pdxbadgers/pcb-2015/gear.bmp

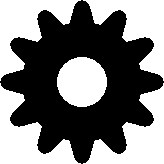
gear.bmp
