pdxbadgers/pcb-2015/badger.brd

## EAGLE design badger.brd (2015-10-04)

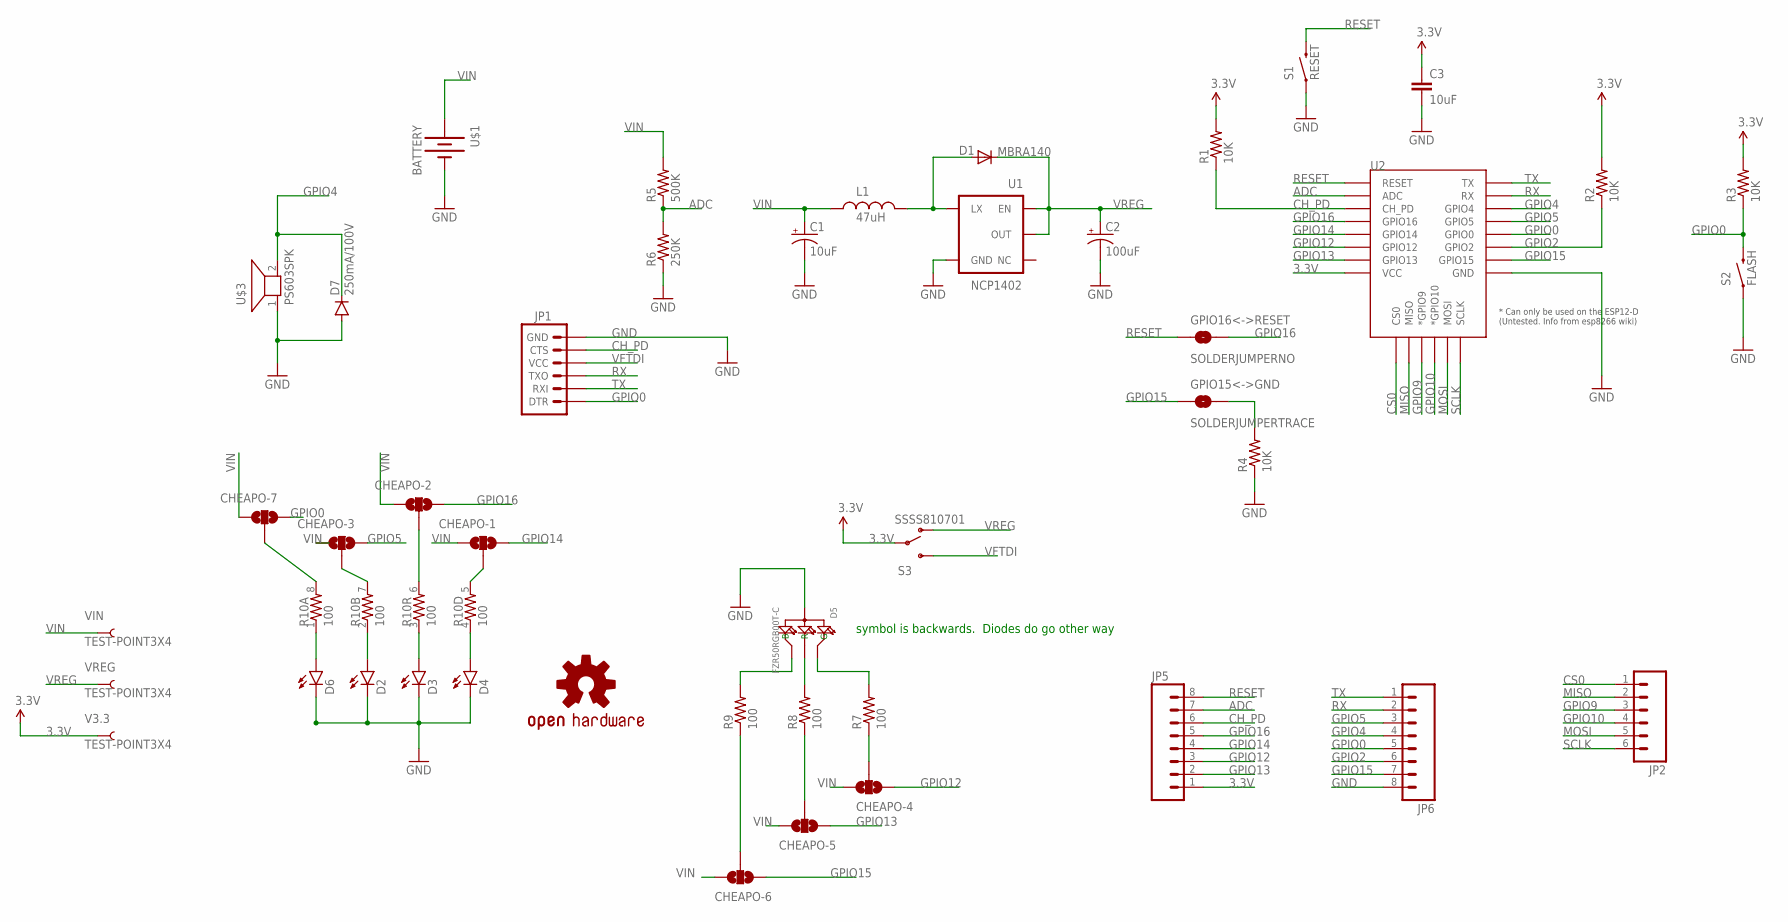
[picture p2: schematic badger.sch]

Parts:
C1: 10uF; EIA3216
C2: 100uF; EIA3528
C3: 10uF; 0603-CAP
CHEAPO-1, CHEAPO-2, CHEAPO-3, CHEAPO-4, CHEAPO-5, CHEAPO-6, CHEAPO-7: SOLDERJUMPER_2WAYT; SJ_2
D1: MBRA140; SMA-DIODE
D2, D3, D4, D6: LED-3MM-NO_SILK; LED3MM-NS
D5: FZR50RGB00T-C; LED4-1.3-D5.0MM
D7: 250mA/100V; SOD-323
GPIO15<->GND: SOLDERJUMPERTRACE; SJ_2S-TRACE
GPIO16<->RESET: SOLDERJUMPERNO; SJ_2S-NO
JP1: ARDUINO_SERIAL_PROGRAMLOCK; 1X06_LOCK
JP2: M06LOCK; 1X06_LOCK
JP5, JP6: M08LOCK; 1X08_LOCK
L1: 47uH; CR54
LOGO1: OSHW-LOGOL-COPPER; OSHW-LOGO-L_COPPER
R1, R2, R3, R4: 10K; 0603-RES
R5: 500K; 0603-RES
R6: 250K; 0603-RES
R7, R8, R9: 100; 1206
R10: 100; 0603-ARV
S1: RESET; TACTILE-SWITCH-SMD
S2: FLASH; TACTILE-SWITCH-SMD
S3: SSSS810701; SSSS8
U1: NCP1402; SOT23-5
U2: ESP12ESMD; ESP12E-SMD
U$1: BATTERY; HOLDER
U$3: PS603SPK; PS603
V3.3: TEST-POINT3X4; PAD.03X.04
VIN: TEST-POINT3X4; PAD.03X.04
VREG: TEST-POINT3X4; PAD.03X.04

Connections:
3.3V: C3.1, JP5.1, R1.2, R2.2, R3.2, S3.P$2, U2.VCC, V3.3.P$1
ADC: JP5.7, R5.1, R6.2, U2.ADC
CH_PD: JP1.5 (CTS), JP5.6, R1.1, U2.CH_PD
CS0: JP2.1, U2.CS0
GND: C1.C (-), C2.C (-), C3.2, D2.K (C), D3.K (C), D4.K (C), D5.C (+), D6.K (C), D7.A, JP1.6 (GND), JP6.8, R4.1, R6.1, S1.1, S2.1, U1.4 (GND), U2.GND, U$1.P$2 (-), U$3.1
GPIO0: CHEAPO-7.3, JP1.1 (DTR), JP6.5, R3.1, S2.3 (2), U2.GPIO0
GPIO2: JP6.6, R2.1, U2.GPIO2
GPIO4: D7.C, JP6.4, U2.GPIO4, U$3.2
GPIO5: CHEAPO-3.3, JP6.3, U2.GPIO5
GPIO9: JP2.3, U2.GPIO9 (*GPIO9)
GPIO10: JP2.4, U2.GPIO10 (*GPIO10)
GPIO12: CHEAPO-4.1, JP5.3, U2.GPIO12
GPIO13: CHEAPO-5.1, JP5.2, U2.GPIO13
GPIO14: CHEAPO-1.3, JP5.4, U2.GPIO14
GPIO15: CHEAPO-6.1, GPIO15<->GND.1, JP6.7, U2.GPIO15
GPIO16: CHEAPO-2.3, GPIO16<->RESET.2, JP5.5, U2.GPIO16
MISO: JP2.2, U2.MISO
MOSI: JP2.5, U2.MOSI
unnamed: GPIO15<->GND.2, R4.2
unnamed: D5.R, R8.2
unnamed: D1.A, L1.P$2 (2), U1.5 (LX)
unnamed: D5.G, R7.2
unnamed: D2.A, R10.2 (1)
unnamed: D3.A, R10.3 (1)
unnamed: D4.A, R10.4 (1)
unnamed: D5.B, R9.2
unnamed: CHEAPO-4.2, R7.1
unnamed: D6.A, R10.1
unnamed: CHEAPO-5.2, R8.1
unnamed: CHEAPO-3.2, R10.7 (2)
unnamed: CHEAPO-2.2, R10.6 (2)
unnamed: CHEAPO-1.2, R10.5 (2)
unnamed: CHEAPO-7.2, R10.8 (2)
unnamed: CHEAPO-6.2, R9.1
RESET: GPIO16<->RESET.1, JP5.8, S1.3 (2), U2.RESET
RX: JP1.3 (TXO), JP6.2, U2.RXD0 (RX)
SCLK: JP2.6, U2.SCLK
TX: JP1.2 (RXI), JP6.1, U2.TXD0 (TX)
VFTDI: JP1.4 (VCC), S3.P$1 (S)
VIN: C1.A (+), CHEAPO-1.1, CHEAPO-2.1, CHEAPO-3.1, CHEAPO-4.3, CHEAPO-5.3, CHEAPO-6.3, CHEAPO-7.1, L1.P$1 (1), R5.2, U$1.P$1 (+), VIN.P$1
VREG: C2.A (+), D1.C, S3.P$3 (O), U1.1 (EN), U1.2 (OUT), VREG.P$1

Notes on the sheet:
symbol is backwards. Diodes do go other way

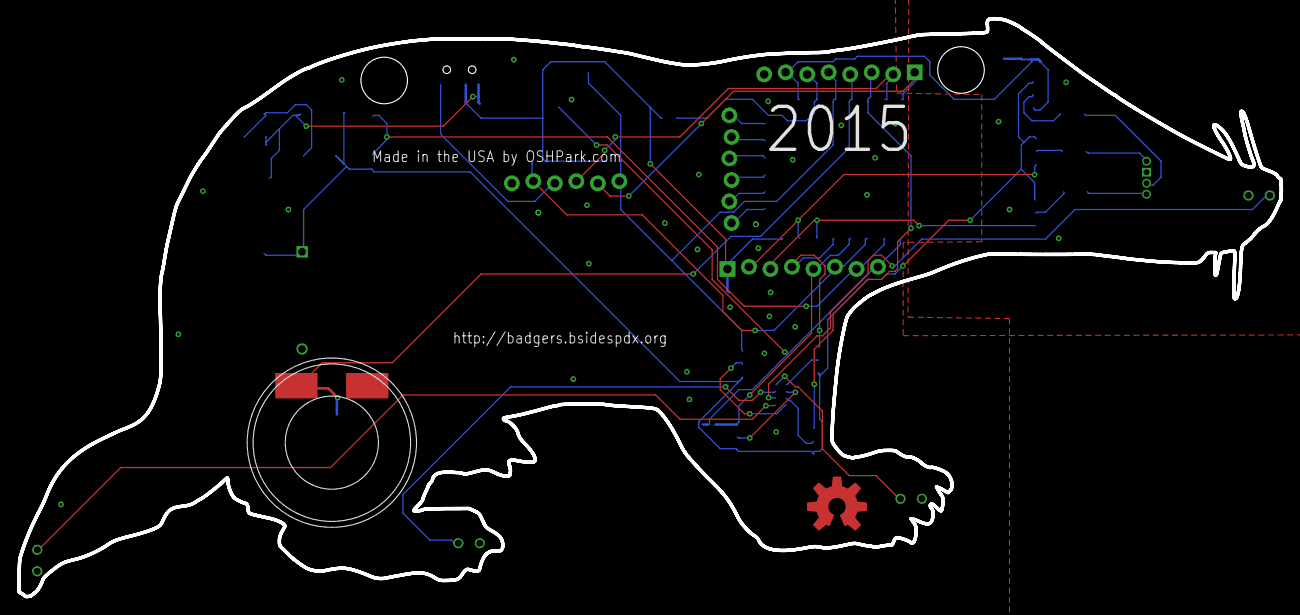
[picture p3: board badger.brd from above]

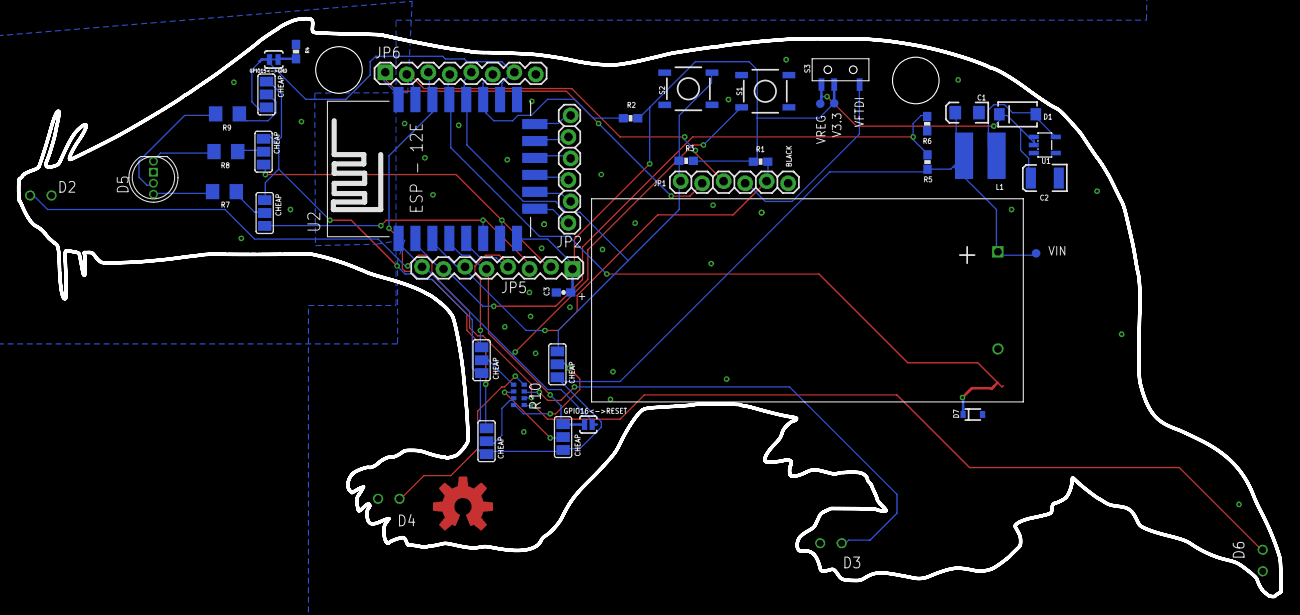
[picture p4: board badger.brd from below]

Board: 2 copper layers, 149.2 x 68.3 mm, 45 parts (43 on the bottom side), 41 nets.
