pdxbadgers/pcb-2015/(threads)

Thread 1 (2015-09-23):

Airwires in board/gerbs sent to itead [75cff57fc1]

briand, 2015-09-23:
The brd file and gerbers in this rev include some airwire issues.

- Jumper trace "GPIO15<->GND" isn't connected to anything.
- The ground pad/pour for S2 and R6 isn't connected to anything. Flash button won't work.

Closed 2015-09-23.

Thread 2 (2015-09-24):

TODO: Move LED footprints to bottom layer

briand, 2015-09-24:
- Move the refdes indicator of LEDs to bottom layer
- Change/move parts to show outline/pin1 on bottom layer

r00tkillah, 2015-09-30:
Think this a fixed?  Led's are on bottom now.

briand, 2015-09-30:
Yup, I'd call that fixed.

On Wednesday, September 30, 2015, Hacker, J.R. <notifications@github.com>
wrote:

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

Closed 2015-09-30.

Thread 5 (2015-09-24):

Speaker is not SMT, needs different connection method

briand, 2015-09-24:
The POP-option speaker doesn't actually SMT down to the board as shown in the part footprint. The footprint is a reproduction of the part itself, but wires must be soldered to the pads and then over to the board.

http://www.mouser.com/catalog/specsheets/KT-400267.pdf

Images here, which explain the situation better: http://www.adafruit.com/products/1891

r00tkillah, 2015-09-24:
crap.  Suggestions?

briand, 2015-09-24:
Traditionally with a speaker like that you'd just glue it down, solder some short wires to the speaker terminals, and solder the wires through some holes on the PCB. If we were to do that I'd want to source pre-wired speakers such as: http://www.adafruit.com/products/1891

Adafruit does carry a through-hole 8ohm speaker; I can't find an alternate distributor with a cursory search: http://www.adafruit.com/products/1898

Could also just go with a through-hole piezo buzzer.

r00tkillah, 2015-09-24:
Well.  sent for proto-run as existing.  We'll try to figure this out before final

r00tkillah, 2015-09-28:
reviewing the items, it looks as if they might be smd mountable with a little work.  The speakers have a blob of solder on the backs of them that just about touch the plane.  With a blob of solder on the board, could possibly get them to bond.  Applying heat sounds tricky, though.

Thread 6 (2015-09-24):

Logos

briand, 2015-09-24:
These are all nice-to-haves.

- BSides logo is converted at a relatively low DPI, and looks a little chunky at 1:1.
- missing year indicator
- missing OSHW logo (already mentioned in #4)

Potential fixes:
- Steal with pride from the Nyan Pirate badge. Joe did a great job with a mixed silk/metal layer logo (although it looks like the public github version is not the same as the badge and doesn't have the logo)
- OSHW logo library: http://www.baconfatlabs.com/2011/11/oshw-eagle-symbols-for-schematic-and-silkscreen/

Also note OSHPark needs the "DPI" to be 2mil width/height boxes or bigger, so don't go too crazy with it. http://support.oshpark.com/support/solutions/articles/107640-problems-with-import-bmp-logos-on-silkscreen

Thread 7 (2015-09-28):

1 remaining airwire on [c59e3852e]

briand, 2015-09-28:
There is still one airwire on the current board, to the GND pin of the ESP. It's happening because the width of the backside ground pour is pretty high (16 mil). If you just drop the width parameter of the poly it will make it through the gap and resolve the airwire.

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

Closed 2015-09-28.

Thread 8 (2015-09-28):

FTDI cable pin 1 not connected to GND

briand, 2015-09-28:
Looks like in the header part swap, GND got disconnected.

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

Closed 2015-09-28.

Thread 9 (2015-10-01):

button footprint doesn't match BOM button

r00tkillah, 2015-10-01:
"The footprints are for a button that has legs folded underneath it, not gull-winged out like the ones we got."
