pdxbadgers/pcb-2015/(commit log)

2015-09-04 add eagle files
    [badger.brd, badger.sch]
2015-09-04 add esp8266 lib and add part
    [badger.brd, badger.sch]
2015-09-08 more updates
    [badger.brd, badger.sch]
2015-09-16 some updates
    [badger.brd, badger.sch]
2015-09-19 add switch and associated scripting
    [badger.brd, badger.sch]
2015-09-22 updates to schematic
    [badger.brd, badger.sch]
2015-09-22 outline, but hit the limits of eagle free
    [badger.brd, badger.sch]
2015-09-22 initial placing
    [badger.brd, badger.sch]
2015-09-22 prior to route
    [badger.brd]
2015-09-23 as sent to itead
    [badger.brd, badger.sch]
2015-09-23 Fix #1
    Thanks to briand!
    [badger.brd]
2015-09-23 make the gnd planes connect a little better on the head
    [badger.brd]
2015-09-24 Fix #3
    All headers now locking
    [badger.brd, badger.sch]
2015-09-24 as sent to oshpark for proto
    [badger.brd, badger.sch]
2015-09-28 fix #8
    [badger.brd, badger.sch]
2015-09-28 fix #7
    [badger.brd]
2015-10-01 Add 5mil dimension buffer; bring vias closer in; reroute
    [badger.brd]
2015-10-01 unrouted fixes
    speaker/pin collision
    add source bitmaps to repo
    bsides logo now hi-res
    oshpark logo
    harmonize (mostly) silk placement and size
    [badger.brd, badger.sch]
2015-10-01 Add polorization mark for C3
    [badger.brd]
2015-10-01 move silk label out out from under speaker
    [badger.brd]
2015-10-01 more groundier
    [badger.brd]
2015-10-01 Add a set of test gerbers to see if cam job is right
2015-10-02 year; r4; url move; button font
    [badger.brd]
2015-10-02 final(?) design? - rerouted - rgb led now with common gnd - rgb led now powered by vin with cheapo varient - new cam
    [badger.brd, badger.sch]
2015-10-02 reapply design rules; dimension/pour 6mil; gnd
    added gnd trace near antenna in case of mill problems
    [badger.brd]
2015-10-04 Another test-spin
    [badger.brd, badger.sch]
2015-10-04 Now without the trestrict
    [badger.brd]
2015-10-04 reconnect diode; via cleanups
    Noticed that stapling vias were octogon and larger drill diameter. Fixed
    [badger.brd, badger.sch]
